bphermansson/EspSparsnasGateway/refrence_doc/RFM69HC_D1mini.png

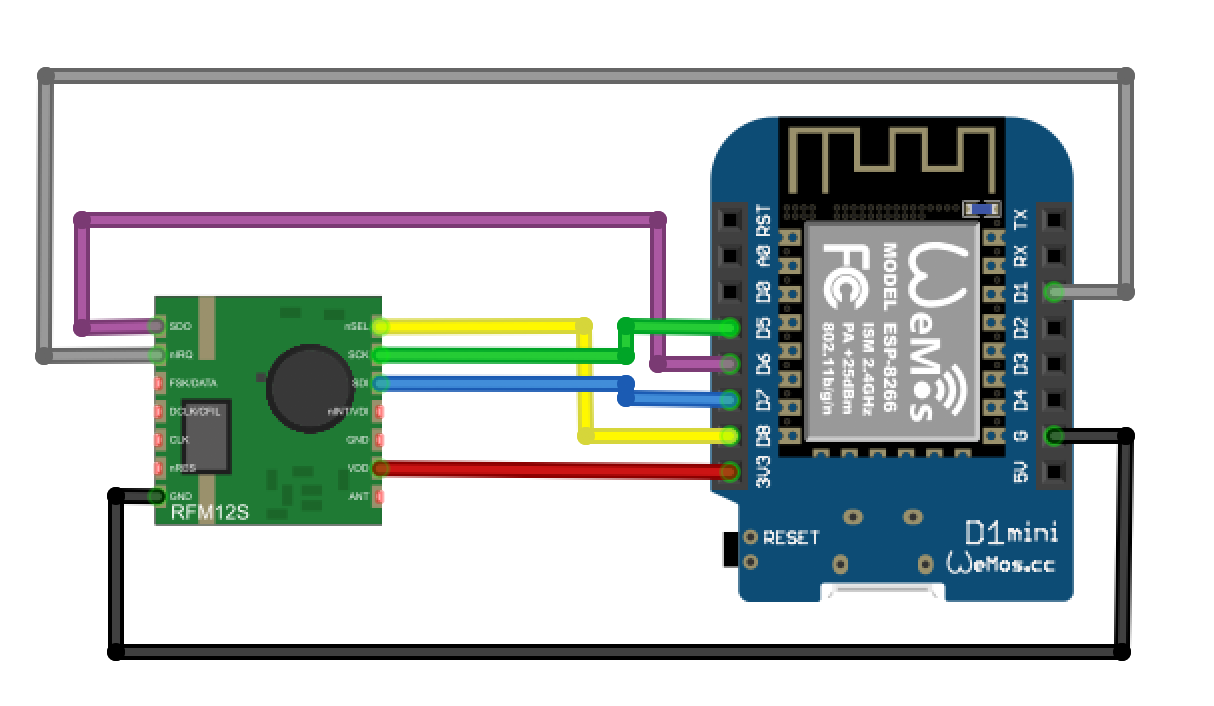
refrence_doc/RFM69HC_D1mini.png
