bphermansson/EspSparsnasGateway/SparnasMqtt.png

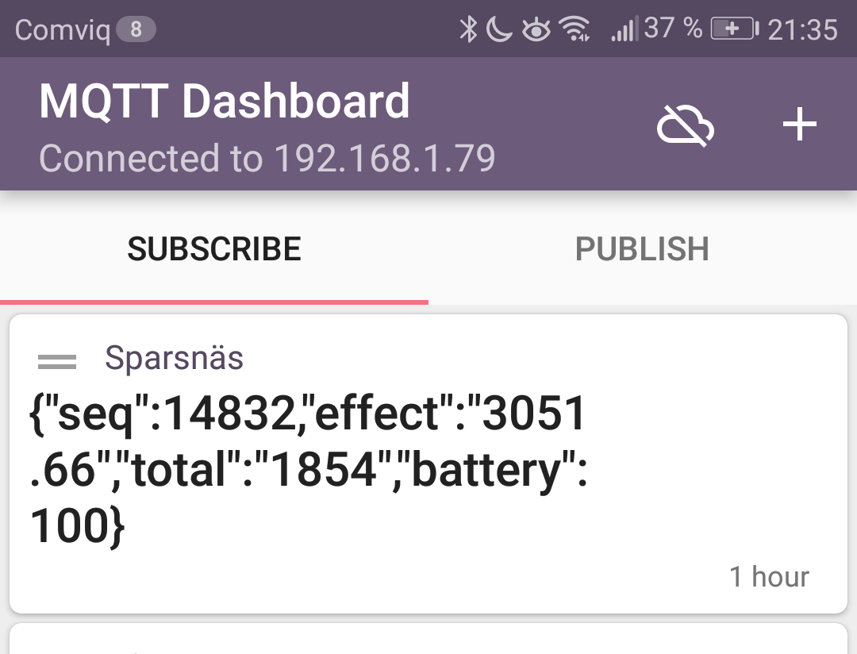
SparnasMqtt.png
