bphermansson/EspSparsnasGateway/(threads)

Thread 1 (2018-01-23):

Port or merge this project to the existing OpenMQTTGateway project?

Hedda, 2018-01-23:
@bphermansson might it be a good idea to port or merge this to the existing OpenMQTTGateway project and maybe join their development team (formerly known as 433toMQTTto433 gateway by 1technophile)?

https://github.com/1technophile/OpenMQTTGateway

OpenMQTTGateway is also a ESP8266 and RFM69 (from HopeRF) RF to MQTT project however it also keeps compatibility with ESP32 and Arduino + W5100 too, and as an additional bonus it supports InfraRed (IR) transmitters and recievers as well:

https://1technophile.github.io/OpenMQTTGateway/

Blog:

https://1technophile.blogspot.se/

RM69 specific blog:

https://1technophile.blogspot.se/2017/09/why-adding-rfm69-compatibility-to.html

Wiki:

https://github.com/1technophile/OpenMQTTGateway/wiki

End-point device compatibility:

https://community.home-assistant.io/t/433tomqttto433-gateway-device-list/7819/7
https://docs.google.com/spreadsheets/d/1DdtVtSsN25nwP6BZI5q6C9yDGz37tUWjw2SQ1RGwBxU/

Good or bad idea?

Hedda, 2018-01-24:
@bphermansson Florian (a.k.a. @1technophile ) wrote here that should be possible if you are willing:

https://gitter.im/OpenMQTTGateway/Questions_support

OpenMQTTGateway project needs a developer who owns a Sparnas and has own interest to add it.

bphermansson, 2018-01-24:
Interresting! Seems like a nice project in many ways. I'll take a look and see what can be done.

Hedda, 2018-01-25:
@bphermansson  Cool! and FYI; another somewhat similar project using ESP8266 and supporting RFM69 is "MySensors":

https://github.com/mysensors/MySensors
https://www.mysensors.org

Interestingly, MySensors (which is a mature project) also happens to come from Swedish developers!

https://github.com/mysensors/MySensors/issues/1034

Posted another seperate feature request for them to implement Sparnas to as linked above.

dogmatic69, 2019-01-21:
This should be closed, it has been a year and these other projects are not interested.

MySensors closed the ticket
OpenMQTTGateway says if they wanted a meter they would build the led blink reader and skip sparsnas.

It's a dead project before it even starts. Had @Hedda perhaps make PR's to these other projects it might have been different but I doubt anything is going to happen.

Closed 2019-01-22.

Thread 3 (2018-01-28):

Rssi always 0

bphermansson, 2018-01-28:
The function to get the Rssi from the receiver always returns 0, should return something like -67.
If we set forceTrigger = true in uint16_t readRSSI (line 304) the code crashes when valid data arrives.

bphermansson, 2018-02-03:
According to the datasheet the rssi can only be read at preamble, ie at start of transmission. The code tries to read it after receiving is done, it should not work. Let's see if we can get and interrupt at the start of transmission and read rssi there instead.

bphermansson, 2018-02-04:
You can also read Rssi just before you read the received package. This is now implemented and this problem is solved.

Closed 2018-02-04.

Thread 4 (2018-01-30):

Issue that values written to MQTT broker does not show the right values

swapper82, 2018-01-30:
When publishing to a mosquitto broker (at least)
i got the values {"seq":989,"power":true,"total":true,"battery":100}
Interprited as bolean values or somting?

i "fixed" the issue by changing to float from string (starting line 458 in the main .ino file)

      else {
        root["seq"] = seq;
        root["power"] = float(watt);
        root["total"] = float(pulse / PULSES_PER_KWH);
        root["battery"] = battery;
        root["rssi"] = float(srssi);
      }

Thanx for a GREAT project :)

bphermansson, 2018-02-03:
Your'e welcome!
Ok, I guess the values are interpreted different with different softwares. But the power and total values are indeed numbers, so I see no problem sending them as floats. I've changed this in the main branch, thanks for the report.

Closed 2018-02-03.

Thread 5 (2018-02-03):

Function to find correct frequency

bphermansson, 2018-02-03:
The transmitter is assumed to send at exactly 868MHz, but that seems to differ between devices. By trial and errror you can get better reception, by changing FREQUENCY in line 69:

uint32_t FREQUENCY = 867980000

It would be nice if the code could find the best frequency by itself.

bphermansson, 2018-02-15:
The new plan is to make it possible to send frequency to use by Mqtt to the unit. This way it will also be possible to set the sender id and maybe more.

Closed 2018-02-18.

Thread 6 (2018-02-11):

Compilation problem

pettib, 2018-02-11:
Hi
I´m trying to compile to project and got error that functions can not be found.
I´m guessing there are something missing, but cant find it.
The board is Wemos D1 running at 115200.

[error.txt](https://github.com/bphermansson/EspSparsnasGateway/files/1714513/error.txt)

regards Peter

bphermansson, 2018-02-15:
Is this the problem with paths that were solved in the Facebook-thread?

Closed 2018-05-03.

Thread 7 (2018-02-12):

Use a Mqtt ping to avoid disconnection

bphermansson, 2018-02-12:
Make the device send a Mqtt message, a "ping", at regular intervalls to avoid disconnection from the broker.

dogmatic69, 2019-01-21:
The pubsub lib already implements a keepalive (`MQTT_KEEPALIVE`) that is pre-set to 15 seconds. There is no need to add another.

dogmatic69, 2019-01-22:
I have configured the ping timeout to a larger value and in 20 minutes have not had a single re-connection.

Closed 2019-01-22.

Thread 8 (2018-02-12):

Setting the frequency via Mqtt

bphermansson, 2018-02-12:
Let the code listen for incoming Mqtt messages with a setting for the receiver frequency. To set the frequency, send something like this:
mosquitto_pub -h 192.168.1.79 -t 'EspSparsnasGateway/settings' -m '{freq:867.999939}'

fredrike, 2018-02-12:
Is it possible to set the sensor ID too?

bphermansson, 2018-02-12:
That would be nice, will give it a try.

bphermansson, 2018-02-18:
The device can now be controlled via Mqtt. We can set the frequency and the senderid, the settings are stored in the Eeprom. We also can clear the settings and reset the device.
But I think theres a bug when setting the frequency, it gets it wrong somehow?

Linuxsmurfen, 2018-04-07:
Could it be that it sets the "ifreq = 868100000;"  on row 317 ?
I tried to remark it and now i'm able to set the frequency via mqtt.

bphermansson, 2018-04-14:
I think that row was for testing. Can you set the frequency and get it right? I haven't managed to get the value set, ie if I set it to 868100000 its reports something like 868000256 back as "Listening on ...".

Naesstrom, 2018-12-10:
I commented out the line on 317 to that @Linuxsmurfen mentioned above, using `EspSparsnasGateway/settings/frequency -m 867.99` give me
```
Message arrived: EspSparsnasGateway/settings/frequency
Payload: 867.99
Frequency change
Set frequency to: 867.99
Wrote: 8
Wrote: 6
Wrote: 7
Wrote: .
Wrote: 9
Wrote: 9
```
Then it reboots and ends the logging with:
```
Stored data:
Found a stored frequency
Stored frequency: 867.99
Calculated frequency: 867990000
There are no stored senderid, using default value
Senderid: 570631
Frequency: 867990000
61.04
Over The Air programming enabled, port: EspSparsnasGateway
Ready
IP address: 192.168.1.201
EspSparsnasGateway @ IP:192.168.1.201 SSID: Katrinelund
In initialize, frequency = 867990000
Adjusted freq: 14221148
61.04
RFM69 init done
Radio initialized.
Listening on 1023999936hz. Done in setup.
```
So even if it says it's saved the new data and repeats it as stored it ends with listenin on another frequency?

bphermansson, 2018-12-19:
Yes. Haven't managed to figure out why.

whyz, 2019-01-09:
fwiw, I have the exact same issue - the requested frequency isn't set. Happy to help in any way I can.

kalj, 2019-01-16:
I guess we can have another go at this now that we have figured out the problem with #20 & #22 ?

dogmatic69, 2019-01-20:
Setting frequency seems to now work, as long as you remove the other line as mentioned above.

Listening on 102399999936hz seems to be a problem with wiring, maybe time to close this ticket?

Closed 2019-01-22.

Thread 9 (2018-02-12):

Calculates wrongly when low/none power usage

tubalainen, 2018-02-12:
The code calculates watts extremely oddly when there isnt a significant load, for example, a load greater than 1000 W.

It reports like 39302 watts when there should be 7 W only.

bphermansson, 2018-02-15:
This we have to look into. Too bad I only have one sender and it's mounted at the power meter. Will see if it's possible to fake values in the code to trigger this bug.

Sperra, 2018-02-18:
Even I have problems with incorrect and extreme values   of effects up to 1.6MW on a 20A main circuit.

The power is calculated according to "watt = (float) ((3600000 / PULSES_PER_KWH) * 1024) / (power);"
Here in the code "power" takes 2bytes.

A high value of "power" will give a low power in W, a value of 65535 produces a minimum power of about 56W. Lower effects seem to get the value of "power" to switch over and start from 0. This seems to match my OpenHab which shows 1.572MW power output. 1.572MW should then correspond to just under 56W the wattage is more reasonable when the values   around such a peak are around 80W.

bphermansson, 2018-02-19:
I'm thinking of letting the code just send raw values, calculations then has to be done by the receiver.

Wonder if this error also shows with Strigeus code, https://github.com/strigeus/sparsnas_decoder?

tubalainen, 2018-02-25:
Looks like the bug exists in the original code as well. Or, there is something fishy with my sparsnäs used for that measurement (got two here at home). The display shows correct values, but both SDR and ESP solution shows the same..

One "ugly fix" is to consider everything under 100 W as 0 in the code... That would help me.

bphermansson, 2018-02-25:
Hmm wait... power is stored in the code as an int, and can therefor be a signed number from -32768 to 32767. The value in the data from the sender is 16 bits with a max of 65535. Not good.
Changing the power type to uint should fix this issue.

bphermansson, 2018-02-25:
That fix is in the code now, hope it works.

fredrike, 2018-02-26:
According to @tubalainen did the `u_int` not help. I've been talking to @bhaap today and apparently was this issue introduced on @tubalainen's code when I changed `PULSES_PER_KWH` from a defined constant to an `int`.

```c
        float watt =  (float)((3600000 / PULSES_PER_KWH) * 1024) / (power);
```

Do we have any samples of output with what the `power` is after the change to `u_int`?  Would it be better to have `power` as `u_int16_t`?

Closed 2018-03-03.

Thread 10 (2018-02-13):

Inductor missing in schematic

bphermansson, 2018-02-13:
Add a inductor (100uH) between the Esp and the Rfm in the schematic.

bphermansson, 2018-02-15:
Fixed

Thread 16 (2018-03-29):

Cannot upload sketch to NodeMCU

pornstrup, 2018-03-29:
Im trying to upload your code to the NodeMCU v.3, but always get an error in arduino saying:
call of overloaded 'readRSSI()' is ambiguous

and this line is marked red:
` uint16_t srssi = readRSSI();`
I´ve downloaded the libraries needed but still get the error. Hope you can help, thanks.

Copy of error message:

Arduino: 1.8.5 (Windows 10), Board: "NodeMCU 1.0 (ESP-12E Module), 80 MHz, 4M (1M SPIFFS), v2 Lower Memory, Disabled, None, Only Sketch, 115200"

C:\Users\Peter Juul Ornstrup\Documents\EspSparsnasGateway-master\EspSparsnasGateway\EspSparsnasGateway.ino: In function 'void interruptHandler()':

EspSparsnasGateway:424: error: call of overloaded 'readRSSI()' is ambiguous

       uint16_t srssi = readRSSI();

                                 ^

C:\Users\Peter Juul Ornstrup\Documents\EspSparsnasGateway-master\EspSparsnasGateway\EspSparsnasGateway.ino:424:33: note: candidates are:

C:\Users\Peter Juul Ornstrup\Documents\EspSparsnasGateway-master\EspSparsnasGateway\RFM69functions.ino:45:10: note: uint16_t readRSSI()

 uint16_t readRSSI() {

          ^

C:\Users\Peter Juul Ornstrup\Documents\EspSparsnasGateway-master\EspSparsnasGateway\EspSparsnasGateway.ino:303:10: note: uint16_t readRSSI(bool)

 uint16_t readRSSI(bool forceTrigger = false) {  // Settings this to true gives a crash...

          ^

C:\Users\Peter Juul Ornstrup\Documents\EspSparsnasGateway-master\EspSparsnasGateway\RFM69functions.ino: In function 'uint32_t getFrequency()':

RFM69functions:1: error: redefinition of 'uint32_t getFrequency()'

 uint32_t getFrequency() {

          ^

EspSparsnasGateway:268: error: 'uint32_t getFrequency()' previously defined here

 uint32_t getFrequency() {

          ^

C:\Users\Peter Juul Ornstrup\Documents\EspSparsnasGateway-master\EspSparsnasGateway\RFM69functions.ino: In function 'void receiveBegin()':

RFM69functions:4: error: redefinition of 'void receiveBegin()'

 void receiveBegin() {

      ^

EspSparsnasGateway:272: error: 'void receiveBegin()' previously defined here

 void receiveBegin() {

      ^

C:\Users\Peter Juul Ornstrup\Documents\EspSparsnasGateway-master\EspSparsnasGateway\RFM69functions.ino: In function 'uint8_t readReg(uint8_t)':

RFM69functions:16: error: redefinition of 'uint8_t readReg(uint8_t)'

 uint8_t readReg(uint8_t addr) {

         ^

EspSparsnasGateway:320: error: 'uint8_t readReg(uint8_t)' previously defined here

 uint8_t readReg(uint8_t addr) {

         ^

C:\Users\Peter Juul Ornstrup\Documents\EspSparsnasGateway-master\EspSparsnasGateway\RFM69functions.ino: In function 'void writeReg(uint8_t, uint8_t)':

RFM69functions:24: error: redefinition of 'void writeReg(uint8_t, uint8_t)'

 void writeReg(uint8_t addr, uint8_t value) {

      ^

EspSparsnasGateway:328: error: 'void writeReg(uint8_t, uint8_t)' previously defined here

 void writeReg(uint8_t addr, uint8_t value) {

      ^

C:\Users\Peter Juul Ornstrup\Documents\EspSparsnasGateway-master\EspSparsnasGateway\RFM69functions.ino: In function 'void select()':

RFM69functions:32: error: redefinition of 'void select()'

 void select() {

      ^

EspSparsnasGateway:336: error: 'void select()' previously defined here

 void select() {

      ^

C:\Users\Peter Juul Ornstrup\Documents\EspSparsnasGateway-master\EspSparsnasGateway\RFM69functions.ino: In function 'void unselect()':

RFM69functions:38: error: redefinition of 'void unselect()'

 void unselect() {

      ^

EspSparsnasGateway:342: error: 'void unselect()' previously defined here

 void unselect() {

      ^

C:\Users\Peter Juul Ornstrup\Documents\EspSparsnasGateway-master\EspSparsnasGateway\RFM69functions.ino: In function 'uint16_t readRSSI()':

RFM69functions:56: error: 'rssi' was not declared in this scope

   rssi = -readReg(REG_RSSIVALUE);

   ^

C:\Users\Peter Juul Ornstrup\Documents\EspSparsnasGateway-master\EspSparsnasGateway\RFM69functions.ino: In function 'bool receiveDone()':

RFM69functions:64: error: redefinition of 'bool receiveDone()'

 bool receiveDone() {

      ^

EspSparsnasGateway:284: error: 'bool receiveDone()' previously defined here

 bool receiveDone() {

      ^

C:\Users\Peter Juul Ornstrup\Documents\EspSparsnasGateway-master\EspSparsnasGateway\RFM69functions.ino: In function 'uint16_t crc16(volatile uint8_t*, size_t)':

RFM69functions:82: error: redefinition of 'uint16_t crc16(volatile uint8_t*, size_t)'

 uint16_t crc16(volatile uint8_t *data, size_t n) {

          ^

EspSparsnasGateway:522: error: 'uint16_t crc16(volatile uint8_t*, size_t)' previously defined here

 uint16_t crc16(volatile uint8_t *data, size_t n) {

          ^

C:\Users\Peter Juul Ornstrup\Documents\EspSparsnasGateway-master\EspSparsnasGateway\callback.ino: In function 'void callback(char*, byte*, unsigned int)':

callback:2: error: redefinition of 'void callback(char*, byte*, unsigned int)'

 void callback(char* topic, byte* payload, unsigned int length) {

      ^

EspSparsnasGateway:566: error: 'void callback(char*, byte*, unsigned int)' previously defined here

 void callback(char* topic, byte* payload, unsigned int length) {

      ^

callback:38: error: 'EEPROM' was not declared in this scope

         EEPROM.write(addr, 1); // Indicate stored settings by writing 1 to Eeprom address 0

         ^

callback:52: error: 'mqtt_debug_topic' was not declared in this scope

         client.publish(mqtt_debug_topic, msg);

                        ^

callback:66: error: 'EEPROM' was not declared in this scope

       EEPROM.write(addr, 1);    // Indicate stored settings by writing 1 to Eeprom address 1

       ^

callback:82: error: 'mqtt_debug_topic' was not declared in this scope

       client.publish(mqtt_debug_topic, msg);

                      ^

callback:90: error: 'EEPROM' was not declared in this scope

         EEPROM.write(i, 0);

         ^

callback:92: error: 'EEPROM' was not declared in this scope

       EEPROM.commit();

       ^

callback:96: error: 'mqtt_debug_topic' was not declared in this scope

       client.publish(mqtt_debug_topic, msg);

                      ^

callback:105: error: 'mqtt_debug_topic' was not declared in this scope

       client.publish(mqtt_debug_topic, msg);

                      ^

exit status 1
call of overloaded 'readRSSI()' is ambiguous

This report would have more information with
"Show verbose output during compilation"
option enabled in File -> Preferences.

bphermansson, 2018-03-31:
You dont need no libraries. Do you have the code in tabs?

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

pornstrup, 2018-03-31:
Yes got the codes in tabs. Will try and start from scratch and see if that helps. Will get back to you. Thanks.

Closed 2018-05-03.

Thread 17 (2018-04-18):

SPI write problem

leifmariposa, 2018-04-18:
Hi,

I have built my own EspSparsnäsGateway with the same parts as in your parts list, but cannot get SPI to write any values. Reading is fine, I always read the default values of the RFM69, no matter what values I have written. For example, first thing that happens in your program is writing 0xAA to REG_SYNCVALUE1, but it always reads as 0x00.
I have connected a logic analyzer on the SPI signals, and it looks fine, MSB is set in the address byte when doing a write.

Also, shouldn't the connection D8(NodeMCU) - EN(RFM69) be D8(NodeMCU) - CS(RFM69) ?

Any help appreciated!

BR
Leif Persson

leifmariposa, 2018-05-06:
I tried to simplify the software as much as possible, but of course the didn't help, the output on SPI is the same according to the logicanalyzer and that seems correct to me after reading the data sheet of the RFM69HCW many times. Today I have ordered new nodemcu and rfm69hcw, will be interesting to see if that will work...

leifmariposa, 2018-05-08:
OK, got a new nodemcu and a new rfm69hcw but with the same result.
This is what the logic analyzer sees: https://ibb.co/bSVzKS

bphermansson, could you please check your connection?
Because I changed the connection between nodemcu-D8 from EN on rfm69 to CS on rfm69, at least reads are working with this. Should the EN on rfm69 be connected?

When studying the logic analyzer output closer you can see that MISO (slave output) goes high immediately after the address byte is sent, regardless if the write bit in the address byte is set or not. Not sure what to make of this though.

Still so confused...

bphermansson, 2018-05-08:
Sorry to hear that. It must be some confusion with the connections. I will take a closer look.
Exactly which components did you buy?

leifmariposa, 2018-05-08:
I bought in at Lawicel,

RFM69HCW Transceiver BoB
Artikelnr: ADA-3070

NodeMCU V3 with ESP-12E / CH340
Artikelnr: K-NM-ESP12E

It should be the components that you recommended but your links doesn't work anymore. I think they changed the url's at Lawicel.

bphermansson, 2018-05-09:
Now I've built another circuit on a protoboard with another RFM69 and another Nodemcu. I used my schematic, unmodified, and the pinout for the Rfm from https://www.mysensors.org/build/connect_radio.
Works just like it should. Hmm.

leifmariposa, 2018-05-09:
Thanks for taking the time to investigate!
When checking mysensors.org I can't fint any break out boards, does this mean you connected directly to a RFM69(HCW) ? Because I can't find any EN signal on the RFM69, only on the break out board, and I left it unconnected on my circuit. Could this maybe be the problem?

bphermansson, 2018-05-09:
Indeed it can. I used a plain Rfm without any breakout board. As noted in my schematic NSS=En.

leifmariposa, 2018-05-11:
OK, so I connected the EN signal on the RFM69 as well, to another output on the nodemcu and then I have tried all possible combinations using the CS and EN signals. NSS=CS, not EN, EN controls the power on/off on the break out board.
So the EN signal must be held high, andwhen it's unconnected it's held high through a pull-up resistor on the break out board.
But I can still not get it to work, from what I can tell the logic analyzer shows that the SPI output is correct, but the RFM69 refuses to make any writes...
The only thing I can think of is that the compunents that I bought is not compatible, could the power supply be too weak?
@bphermansson, exactly which components did you use? And where did you by them?
Or would you be willing to sell me a pair of working NodeMcu/RFM69 if you have extra?

bphermansson, 2018-05-15:
This is your breakout? https://www.adafruit.com/product/3070
It has a level converter and a voltage regulator. Do you connect 5V to Vin?
I have a RFM to sell if you want, but not many Nodemcu:s.

leifmariposa, 2018-05-16:
Yes, that is the breakout I'm using, I have tried with both 3.3V and 5V supply, same problem.
I've recently found this, Adafruit Feather M0 RFM69HCW Packet Radio
https://www.lawicel-shop.se/catalog/product/view/id/5656/s/adafruit-feather-m0-rfm69hcw-packet-radio/
so I will by that one instead to get rid of all this hassle, it's not very expensive.
Anyway, thanks for all your help!

bphermansson, 2018-05-24:
Ok, hope that works!

mircopz, 2021-05-28:
@leifmariposa did you solve the write error problem with RFM69? I'm facing the same issue...

mircopz, 2021-05-31:
@leifmariposa I don't know if you are still interested in... I saw that you participated in this topic https://forums.adafruit.com/viewtopic.php?f=19&p=672114
I had the same registers dump when reading, and I solved it when I changed reset pin logic. It's not active low (as the 99% of devices), but active high! So I was communicating with it in reset conditions, and maybe only some registers latch the default values.
Inverting the reset logic everything works correctly.

leifmariposa, 2021-05-31:
Great that you got it working! I'm using another solution now, but thanks for the info!

Closed 2019-01-22.

Thread 20 (2018-08-05):

Listening to the wrong frequency

Freland, 2018-08-05:
For some reason the log gives me "Listening on 1023999936hz. Done in setup." even though I've set the frequency: "Stored frequency: 867999900". Since it is listening to the wrong freq. I don't get any data. I've tried updating the freq. with MQTT with no luck.

Logfile:
```
Debug on
Vcc=3014
Stored data: 1
There are stored settings
Stored frequency: 867999900
Stored sender id: d2a94a
Over The Air programming enabled, port: EspSparsnasGateway
Attempting MQTT connection...Connected to Mqtt broker as EspSparsnasGateway
Ready
IP address: 192.168.1.XX
EspSparsnasGateway @ IP:192.168.1.XX SSID: XXXXXX
Stored freq: 867999900
RFM69 init done
Radio initialized.
Listening on 1023999936hz. Done in setup.
```

kalj, 2019-01-13:
See #22 and #25 . Can probably be closed.

dogmatic69, 2019-01-18:
I have been debugging this tonight and think I have found the problem. The frequency is not written to the registry on the board (or possibly the read is not working)

```
  Serial.print("frequency: ");
  Serial.println(frequency);
  for (uint8_t i = 0; CONFIG[i][0] != 255; i++) {
    Serial.print("writeReg: ");
    Serial.print(CONFIG[i][0]);
    Serial.print(": ");
    Serial.println(CONFIG[i][1]);
    writeReg(CONFIG[i][0], CONFIG[i][1]);
    yield();
  }
```
gives the following output (trimmed for brevity):

```
22:35:08.830 -> frequency: 1422114
....
22:35:08.830 -> writeReg: 7: 21
22:35:08.830 -> writeReg: 8: 179
22:35:08.830 -> writeReg: 9: 34
```

Whilst the `getFrequency` method call has this:

```
  Serial.println("readReg: ");

  Serial.print(REG_FRFMSB);
  Serial.print(": ");
  Serial.println((readReg(REG_FRFMSB)));

  Serial.print(REG_FRFMID);
  Serial.print(": ");
  Serial.println(readReg(REG_FRFMID));

  Serial.print(REG_FRFLSB);
  Serial.print(": ");
  Serial.println(readReg(REG_FRFLSB));

  Serial.print("frequency: ");
  Serial.println((
    ((uint32_t)readReg(REG_FRFMSB) << 16) +
    ((uint16_t)readReg(REG_FRFMID) << 8) +
    (uint8_t)readReg(REG_FRFLSB)
  ));
```

And the output is:
```
22:35:08.863 -> readReg:
22:35:08.863 -> 7: 255
22:35:08.863 -> 8: 255
22:35:08.863 -> 9: 255
22:35:08.863 -> frequency: 16777215
```

kalj, 2019-01-19:
@dogmatic69 Are your issue the same as the one we eventually sorted out in #22 ? Many of us had this exact problem when the MOSI/MISO wires were swapped and/or leaving the RST pin of the Adafruit RFM69HCW BoB unwired to ground. Using the new schematic #27 it seems we all get it to work. Also, have you included the error checks in #25? Those can help ruling out a failed initialization.

dogmatic69, 2019-01-19:
Was missing the reset connected to ground! Now the registries are written.

bphermansson, 2019-01-19:
Great work! Since I lack time for this project I invited Naesstrom and Freland as collaborators. Anyone else wanna join?

kalj, 2019-01-19:
@bphermansson I would love to tag along. :)

dogmatic69, 2019-01-23:
This should now be sorted. If still getting that it listens to the wrong frequency check the wiring and make sure that registries that are written to actually have the correct values (eg: write -> read -> compare value). If that does not work the frequency is not being written to the registry and is probably due to wiring issue.

Closed 2019-01-23.

Thread 21 (2018-09-12):

Text corrections?

Naesstrom, 2018-09-12:
Just wanted to check what instructions to follow, in the build instructions you suggest using a "330-470uF" capacitor but in the links and the schematic it's a 1000uF?

Naesstrom, 2018-09-20:
Sweet, still waiting for my PCB's but think I have all the parts already!
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

Closed 2018-10-31.

Thread 22 (2018-10-31):

No values?

Naesstrom, 2018-10-31:
So I finally got around to assembling this, even added a sma contact and a 868 antenna to the breakout board.
Serial monitor just gives me this:
```
Attempting MQTT connection...Connected to Mqtt broker as EspSparsnasGateway
Stored data:
There are no stored frequency, using default value
There are no stored senderid, using default value
Senderid: 570631
Frequency: 868000000
61.04
Over The Air programming enabled, port: EspSparsnasGateway
Ready
IP addre
```
The senderid is the one I entered and the frequency looks right to, the strange thing is that it cuts out before it even tells me the IP... Debug is set to 1 btw.

On the mqtt side of things it repeats the following 4 rows a couple of times
```
{"status":"Connected to Mqtt broker as EspSparsnasGateway"}
{"status":"There are no stored frequency, using default value"}
{"status":"There are no stored senderid, using default value"}
{"status":"EspSparsnasGateway @ IP:192.168.1.201 SSID: Katrinelund"}
```

The really strange thing tough is that if I disconnect the ESP from everything and run it the monitor seems to work?
```
Attempting MQTT connection...Connected to Mqtt broker as EspSparsnasGateway
Stored data:
There are no stored frequency, using default value
There are no stored senderid, using default value
Senderid: 570631
Frequency: 868000000
61.04
Over The Air programming enabled, port: EspSparsnasGateway
Ready
IP address: 192.168.1.201
EspSparsnasGateway @ IP:192.168.1.201 SSID: Katrinelund
In initialize, frequency = 868100000
Adjusted freq: 14222950
61.04
RFM69 init done
Radio initialized.
Listening on 1023999936hz. Done in setup.
```

Naesstrom, 2018-10-31:
Did some more debugging, running the ESP with everything but the RFM69 unit I get a complete startup in the serial monitor to... starting to think that my module might be DOA...

bphermansson, 2018-10-31:
What esp-module are you using? What kind of power supply?

Naesstrom, 2018-11-01:
NodeMCU v3 (lolin) and just USB power from the PC atm.

Naesstrom, 2018-11-03:
Running it with a 1A external poweradapter gives me:
```
Welcome to EspSparsnasGateway
Compiled at:Oct 30 2018 21:51:42
Debug on
Vcc=2923
Attempting MQTT connection...Connected to Mqtt broker as EspSparsnasGateway
Stored data:
There are no stored frequency, using default value
There are no stored senderid, using default value
Senderid: 570631
Frequency: 868000000
61.04
Over The Air programming enabled, port: EspSparsnasGateway
Ready
IP address: 192.168.1.201
EspSparsnasGateway @ IP:192.168.1.201 SSID: Katrinelund
In initialize, frequency = 868100000
Adjusted freq: 14222950
61.04
Failed on waiting for ModeReady()
Unable to initialize the radio. Exiting.
```
Not sure what it means with `Failed on waiting for ModeReady()`

bphermansson, 2018-11-03:
Can you try to set the frequency in the code?

Naesstrom, 2018-11-07:
Redid the wiring on a breadboard but still the same result when connecting 12V power... Radio is getting 3.3V to.
```
Compiled at:Oct 30 2018 21:51:42
Debug on
Vcc=2928
Attempting MQTT connection...Connected to Mqtt broker as EspSparsnasGateway
Stored data:
There are no stored frequency, using default value
There are no stored senderid, using default value
Senderid: 570631
Frequency: 868000000
61.04
Over The Air programming enabled, port: EspSparsnasGateway
Ready
IP address: 192.168.1.201
EspSparsnasGateway @ IP:192.168.1.201 SSID: Katrinelund
In initialize, frequency = 868100000
Adjusted freq: 14222950
61.04
Failed on waiting for ModeReady()
Unable to initialize the radio. Exiting.
```

Naesstrom, 2018-11-07:
Been googling and trying to find what might be causing it... only thing I found is related to the [rst pin](https://forum.mysensors.org/topic/5954/rfm69-not-initialising-required-reset-could-be-the-cause/5) but since it's been working for you it can't be that!

bphermansson, 2018-11-08:
Maybe try another software to see if it's a hardware or software problem? Like this: https://github.com/bbx10/nanohab

Naesstrom, 2018-11-08:
yup, that seems to be initializing the radio
```
RFM69 WiFi Gateway
External System
*WM:
*WM: AutoConnect
*WM: Connecting as wifi client...
*WM: Using last saved values, should be faster
*WM: Connection result:
*WM: 3
*WM: IP Address:
*WM: 192.168.1.201
connected
*WM: freeing allocated params!
MDNS responder started
Connect to http://rfm69gw1.local or http://192.168.1.201

Listening at 868 86 MHz
Attempting MQTT connection...failed, rc=-2 try again in 2 seconds
```
Having some problems with my mqtt atm. tough but thats unrelated.

Just a thought, I'm using a RFM69HCW and in the software you linked he differs between them for some reason with `    radio.setHighPower();    // Only for RFM69HCW & HW!` can that be something?

Sorry for being such a PITA btw

bphermansson, 2018-11-15:
Might be, try to comment that line?

Naesstrom, 2018-11-19:
Not sure I follow what you mean right now, this software that you linked https://github.com/bbx10/nanohab managed to initialize the radio- The part with `radio.setHighPower` is from that git and not yours.
Do you mean I should comment that out from the above mentioned firmware and see if it still initializes the radio?

Naesstrom, 2018-12-10:
After switching mosi/miso I got it booting up atleast... D6 --> MOSI and D7 --> MISO
Can't really understand why since according to all the sheets I can read it shouldn't work this way...
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

```
Compiled at:Nov  8 2018 16:43:01
Debug on
Vcc=2928
Attempting MQTT connection...Connected to Mqtt broker as EspSparsnasGateway
Stored data:
There are no stored frequency, using default value
There are no stored senderid, using default value
Senderid: 570631
Frequency: 868000000
61.04
Over The Air programming enabled, port: EspSparsnasGateway
Ready
IP address: 192.168.1.201
EspSparsnasGateway @ IP:192.168.1.201 SSID: Katrinelund
In initialize, frequency = 868100000
Adjusted freq: 14222950
61.04
RFM69 init done
Radio initialized.
Listening on 1023999936hz. Done in setup.
```

Freland, 2018-12-10:
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

Seems like it is exactly the same issue I had when I tried getting it up and running a while back ago (https://github.com/bphermansson/EspSparsnasGateway/issues/20 )

Naesstrom, 2018-12-10:
hehe, ja det var ditt förslag i [elektronikforumet](http://elektronikforumet.com/forum/viewtopic.php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) som gav mig iden att testa att switcha plats på dom!
Har du någonsin fått det att fungera @Freland

Naesstrom, 2018-12-11:
Efter att ha diskuterat på FB, granskat kopplingsscheman etc. har jag en ny fundering... Enligt sommarlov's skiss så skall ju NSS kopplas till GPIO15 och det skriver @bphermansson i sin schematic!

Kollar jag däremot på Adafruits egna inkopplingsschema för RFM69HCW så har dom ingen koppling till EN då den automatiskt är på men däremot från samma GPIO till CS
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

Naesstrom, 2018-12-11:
Typ såhär:
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

dogmatic69, 2019-01-16:
> RST - this is the Reset pin for the radio. It's pulled high by default. Pull down to ground to put it into reset

Seems that you should pull it down to reset, not permanently.

Naesstrom, 2019-01-17:
Hmm, then it should be done in the code then... I'm running mine now with gnd connected to it and it seems to be running fine

dogmatic69, 2019-01-23:
I'm going to go ahead and close this issue as the code fixes are now in and the other part seems to be a hookup issue. If you still got an error open a new ticket for it.

Closed 2019-01-23.

Thread 28 (2019-01-19):

Bad data

dogmatic69, 2019-01-19:
Now I have it running, but the data seems to be bad. I've tried to change the flag in the config mentioned in the readme but that did not help.

```
    if (TEMPDATA[0] != 0x11 || TEMPDATA[1] != (SENSOR_ID & 0xFF) || TEMPDATA[3] != 0x07 || rcv_sensor_id != SENSOR_ID) {
      Serial.println("Bad data");

      Serial.print("data_0: ");
      Serial.println(TEMPDATA[0]);

      Serial.print("data_1: ");
      Serial.println(TEMPDATA[1]);

      Serial.print("SENSOR_ID & 0xFF: ");
      Serial.println(SENSOR_ID & 0xFF);

      Serial.print("data_3: ");
      Serial.println(TEMPDATA[3]);

      Serial.print("rcv_sensor_id: ");
      Serial.println(rcv_sensor_id);

      Serial.print("SENSOR_ID: ");
      Serial.println(SENSOR_ID);
```

output:

```
08:51:27.321 -> Got rf data
08:51:27.321 -> Bad data
08:51:27.321 -> data_0: 238
08:51:27.321 -> data_1: 101
08:51:27.321 -> SENSOR_ID & 0xFF: 93
08:51:27.355 -> data_3: 196
08:51:27.355 -> rcv_sensor_id: 215117836
08:51:27.355 -> SENSOR_ID: 542045
08:51:33.333 -> Got rf data
08:51:33.333 -> Bad data
08:51:33.333 -> data_0: 85
08:51:33.333 -> data_1: 93
08:51:33.333 -> SENSOR_ID & 0xFF: 93
08:51:33.333 -> data_3: 69
08:51:33.333 -> rcv_sensor_id: 4157798087
08:51:33.333 -> SENSOR_ID: 542045
```

dogmatic69, 2019-01-19:
Got it working now by commenting out the hard coded value for the sensor before `initialize`. Not sure why that is even there when you are setting it above or via MQTT.

Seen some other posts here about removing it so maybe it should be removed totally...
```
  // ifreq = 868100000;
```

Naesstrom, 2019-01-21:
Thanks, I'll make sure to edit that out of the code!

Closed 2019-01-21.

Thread 30 (2019-01-20):

MQTT is not stable, many missed packets.

dogmatic69, 2019-01-20:
After running for a while this is my logs, you can see many missed pakets. The Sparsnas is sending around every 15 seconds (seen in the serial debugger), but the MQTT subscriber is only getting a fraction of what is sent.

Look at the `seq` below, this is what MQTT is actually processing.

```$ mosquitto_sub -v -h hassio.home -V mqttv311 -u mqtt -P mqtt -t "EspSparsnasGateway/#"
EspSparsnasGateway/debug {"status":"Connected to Mqtt broker as EspSparsnasGateway"}
EspSparsnasGateway/values {"seq":43362,"watt":2792.727,"total":205.451,"pulse":"205451","battery":100,"rssi":"-101","power":"1320"}
EspSparsnasGateway/debug {"status":"Connected to Mqtt broker as EspSparsnasGateway"}
EspSparsnasGateway/values {"seq":43384,"watt":2378.323,"total":205.702,"pulse":"205702","battery":100,"rssi":"-86","power":"1550"}
EspSparsnasGateway/debug {"status":"Connected to Mqtt broker as EspSparsnasGateway"}
EspSparsnasGateway/debug {"status":"Connected to Mqtt broker as EspSparsnasGateway"}
EspSparsnasGateway/debug {"status":"Connected to Mqtt broker as EspSparsnasGateway"}
EspSparsnasGateway/debug {"status":"Connected to Mqtt broker as EspSparsnasGateway"}
EspSparsnasGateway/debug {"status":"Connected to Mqtt broker as EspSparsnasGateway"}
EspSparsnasGateway/values {"seq":43558,"watt":2963.344,"total":207.677,"pulse":"207677","battery":100,"rssi":"-85","power":"1244"}
EspSparsnasGateway/values {"seq":43564,"watt":3056.716,"total":207.753,"pulse":"207753","battery":100,"rssi":"-93","power":"1206"}
EspSparsnasGateway/debug {"status":"Connected to Mqtt broker as EspSparsnasGateway"}
EspSparsnasGateway/debug {"status":"Connected to Mqtt broker as EspSparsnasGateway"}
EspSparsnasGateway/values {"seq":43608,"watt":1253.025,"total":208.207,"pulse":"208207","battery":100,"rssi":"-84","power":"2942"}
EspSparsnasGateway/debug {"status":"Connected to Mqtt broker as EspSparsnasGateway"}
EspSparsnasGateway/debug {"status":"Connected to Mqtt broker as EspSparsnasGateway"}
EspSparsnasGateway/values {"seq":43652,"watt":1466.348,"total":208.467,"pulse":"208467","battery":100,"rssi":"-94","power":"2514"}
EspSparsnasGateway/debug {"status":"Connected to Mqtt broker as EspSparsnasGateway"}
EspSparsnasGateway/debug {"status":"Connected to Mqtt broker as EspSparsnasGateway"}
EspSparsnasGateway/values {"seq":43677,"watt":701.3699,"total":208.602,"pulse":"208602","battery":100,"rssi":"-86","power":"5256"}
EspSparsnasGateway/debug {"status":"Connected to Mqtt broker as EspSparsnasGateway"}
EspSparsnasGateway/values {"seq":43788,"watt":607.7151,"total":208.878,"pulse":"208878","battery":100,"rssi":"-82","power":"6066"}
EspSparsnasGateway/debug {"status":"Connected to Mqtt broker as EspSparsnasGateway"}
EspSparsnasGateway/values {"seq":43793,"watt":920.6793,"total":208.892,"pulse":"208892","battery":100,"rssi":"-91","power":"4004"}
EspSparsnasGateway/debug {"status":"Connected to Mqtt broker as EspSparsnasGateway"}
EspSparsnasGateway/debug {"status":"Connected to Mqtt broker as EspSparsnasGateway"}
EspSparsnasGateway/values {"seq":43840,"watt":1044.602,"total":209.011,"pulse":"209011","battery":100,"rssi":"-90","power":"3529"}
EspSparsnasGateway/debug {"status":"Connected to Mqtt broker as EspSparsnasGateway"}
EspSparsnasGateway/debug {"status":"Connected to Mqtt broker as EspSparsnasGateway"}
EspSparsnasGateway/values {"seq":43882,"watt":7200,"total":209.107,"pulse":"209107","battery":100,"rssi":"-88","power":"512"}
EspSparsnasGateway/debug {"status":"Connected to Mqtt broker as EspSparsnasGateway"}
EspSparsnasGateway/debug {"status":"Connected to Mqtt broker as EspSparsnasGateway"}
EspSparsnasGateway/debug {"status":"Connected to Mqtt broker as EspSparsnasGateway"}
EspSparsnasGateway/values {"seq":43935,"watt":641.3361,"total":209.275,"pulse":"209275","battery":100,"rssi":"-87","power":"5748"}
EspSparsnasGateway/debug {"status":"Connected to Mqtt broker as EspSparsnasGateway"}
EspSparsnasGateway/values {"seq":43939,"watt":560.7545,"total":209.285,"pulse":"209285","battery":100,"rssi":"-86","power":"6574"}
EspSparsnasGateway/debug {"status":"Connected to Mqtt broker as EspSparsnasGateway"}
EspSparsnasGateway/values {"seq":43972,"watt":457.0295,"total":209.371,"pulse":"209371","battery":100,"rssi":"-85","power":"8066"}
EspSparsnasGateway/debug {"status":"Connected to Mqtt broker as EspSparsnasGateway"}
EspSparsnasGateway/debug {"status":"Connected to Mqtt broker as EspSparsnasGateway"}
EspSparsnasGateway/debug {"status":"Connected to Mqtt broker as EspSparsnasGateway"}
EspSparsnasGateway/values {"seq":44011,"watt":1142.715,"total":209.579,"pulse":"209579","battery":100,"rssi":"-88","power":"3226"}
EspSparsnasGateway/debug {"status":"Connected to Mqtt broker as EspSparsnasGateway"}
EspSparsnasGateway/debug {"status":"Connected to Mqtt broker as EspSparsnasGateway"}
EspSparsnasGateway/debug {"status":"Connected to Mqtt broker as EspSparsnasGateway"}
EspSparsnasGateway/values {"seq":44126,"watt":996.3243,"total":210.235,"pulse":"210235","battery":100,"rssi":"-90","power":"3700"}
EspSparsnasGateway/debug {"status":"Connected to Mqtt broker as EspSparsnasGateway"}
EspSparsnasGateway/debug {"status":"Connected to Mqtt broker as EspSparsnasGateway"}
EspSparsnasGateway/debug {"status":"Connected to Mqtt broker as EspSparsnasGateway"}
EspSparsnasGateway/values {"seq":44171,"watt":3145.393,"total":210.74,"pulse":"210740","battery":100,"rssi":"-85","power":"1172"}
EspSparsnasGateway/debug {"status":"Connected to Mqtt broker as EspSparsnasGateway"}
EspSparsnasGateway/debug {"status":"Connected to Mqtt broker as EspSparsnasGateway"}
EspSparsnasGateway/values {"seq":44199,"watt":3432.402,"total":211.139,"pulse":"211139","battery":100,"rssi":"-85","power":"1074"}
EspSparsnasGateway/debug {"status":"Connected to Mqtt broker as EspSparsnasGateway"}
EspSparsnasGateway/debug {"status":"Connected to Mqtt broker as EspSparsnasGateway"}
EspSparsnasGateway/debug {"status":"Connected to Mqtt broker as EspSparsnasGateway"}
EspSparsnasGateway/debug {"status":"Connected to Mqtt broker as EspSparsnasGateway"}
EspSparsnasGateway/debug {"status":"Connected to Mqtt broker as EspSparsnasGateway"}
EspSparsnasGateway/debug {"status":"Connected to Mqtt broker as EspSparsnasGateway"}
EspSparsnasGateway/debug {"status":"Connected to Mqtt broker as EspSparsnasGateway"}
EspSparsnasGateway/debug {"status":"Connected to Mqtt broker as EspSparsnasGateway"}
EspSparsnasGateway/debug {"status":"Connected to Mqtt broker as EspSparsnasGateway"}
EspSparsnasGateway/values {"seq":44371,"watt":6083.168,"total":212.872,"pulse":"212872","battery":100,"rssi":"-82","power":"606"}
EspSparsnasGateway/debug {"status":"Connected to Mqtt broker as EspSparsnasGateway"}
EspSparsnasGateway/values {"seq":44381,"watt":3824.066,"total":213.062,"pulse":"213062","battery":100,"rssi":"-87","power":"964"}
EspSparsnasGateway/values {"seq":44382,"watt":4015.686,"total":213.078,"pulse":"213078","battery":100,"rssi":"-94","power":"918"}
EspSparsnasGateway/debug {"status":"Connected to Mqtt broker as EspSparsnasGateway"}
EspSparsnasGateway/debug {"status":"Connected to Mqtt broker as EspSparsnasGateway"}
EspSparsnasGateway/debug {"status":"Connected to Mqtt broker as EspSparsnasGateway"}
EspSparsnasGateway/values {"seq":44399,"watt":5008.696,"total":213.4,"pulse":"213400","battery":100,"rssi":"-91","power":"736"}
EspSparsnasGateway/debug {"status":"Connected to Mqtt broker as EspSparsnasGateway"}
EspSparsnasGateway/debug {"status":"Connected to Mqtt broker as EspSparsnasGateway"}
EspSparsnasGateway/debug {"status":"Connected to Mqtt broker as EspSparsnasGateway"}
EspSparsnasGateway/values {"seq":44410,"watt":4596.509,"total":213.623,"pulse":"213623","battery":100,"rssi":"-89","power":"802"}
EspSparsnasGateway/values {"seq":44411,"watt":4585.075,"total":213.642,"pulse":"213642","battery":100,"rssi":"-82","power":"804"}
EspSparsnasGateway/debug {"status":"Connected to Mqtt broker as EspSparsnasGateway"}
EspSparsnasGateway/values {"seq":44425,"watt":2949.12,"total":213.838,"pulse":"213838","battery":100,"rssi":"-88","power":"1250"}
EspSparsnasGateway/debug {"status":"Connected to Mqtt broker as EspSparsnasGateway"}
EspSparsnasGateway/values {"seq":44462,"watt":4738.303,"total":214.514,"pulse":"214514","battery":100,"rssi":"-83","power":"778"}
EspSparsnasGateway/debug {"status":"Connected to Mqtt broker as EspSparsnasGateway"}
EspSparsnasGateway/values {"seq":44488,"watt":4517.647,"total":215.11,"pulse":"215110","battery":100,"rssi":"-90","power":"816"}
EspSparsnasGateway/values {"seq":44489,"watt":4506.602,"total":215.129,"pulse":"215129","battery":100,"rssi":"-81","power":"818"}
EspSparsnasGateway/debug {"status":"Connected to Mqtt broker as EspSparsnasGateway"}
EspSparsnasGateway/debug {"status":"Connected to Mqtt broker as EspSparsnasGateway"}
EspSparsnasGateway/values {"seq":44495,"watt":4619.549,"total":215.243,"pulse":"215243","battery":100,"rssi":"-87","power":"798"}
EspSparsnasGateway/values {"seq":44496,"watt":4573.697,"total":215.263,"pulse":"215263","battery":100,"rssi":"-88","power":"806"}
EspSparsnasGateway/debug {"status":"Connected to Mqtt broker as EspSparsnasGateway"}
EspSparsnasGateway/values {"seq":44511,"watt":3963.871,"total":215.495,"pulse":"215495","battery":100,"rssi":"-89","power":"930"}
EspSparsnasGateway/debug {"status":"Connected to Mqtt broker as EspSparsnasGateway"}
EspSparsnasGateway/debug {"status":"Connected to Mqtt broker as EspSparsnasGateway"}
EspSparsnasGateway/debug {"status":"Connected to Mqtt broker as EspSparsnasGateway"}
EspSparsnasGateway/values {"seq":44573,"watt":2972.903,"total":216.365,"pulse":"216365","battery":100,"rssi":"-85","power":"1240"}
EspSparsnasGateway/values {"seq":44574,"watt":3006.852,"total":216.377,"pulse":"216377","battery":100,"rssi":"-85","power":"1226"}
EspSparsnasGateway/values {"seq":44575,"watt":3006.852,"total":216.39,"pulse":"216390","battery":100,"rssi":"-88","power":"1226"}
EspSparsnasGateway/debug {"status":"Connected to Mqtt broker as EspSparsnasGateway"}
EspSparsnasGateway/values {"seq":44578,"watt":2963.344,"total":216.427,"pulse":"216427","battery":100,"rssi":"-82","power":"1244"}
EspSparsnasGateway/debug {"status":"Connected to Mqtt broker as EspSparsnasGateway"}
EspSparsnasGateway/values {"seq":44583,"watt":3245.07,"total":216.493,"pulse":"216493","battery":100,"rssi":"-95","power":"1136"}
EspSparsnasGateway/debug {"status":"Connected to Mqtt broker as EspSparsnasGateway"}
EspSparsnasGateway/debug {"status":"Connected to Mqtt broker as EspSparsnasGateway"}
EspSparsnasGateway/values {"seq":44607,"watt":4837.795,"total":216.847,"pulse":"216847","battery":100,"rssi":"-83","power":"762"}
EspSparsnasGateway/values {"seq":44608,"watt":4775.129,"total":216.869,"pulse":"216869","battery":100,"rssi":"-84","power":"772"}
EspSparsnasGateway/debug {"status":"Connected to Mqtt broker as EspSparsnasGateway"}
EspSparsnasGateway/values {"seq":44614,"watt":3194.454,"total":216.978,"pulse":"216978","battery":100,"rssi":"-88","power":"1154"}
EspSparsnasGateway/values {"seq":44615,"watt":3188.927,"total":216.991,"pulse":"216991","battery":100,"rssi":"-91","power":"1156"}
EspSparsnasGateway/values {"seq":44616,"watt":3245.07,"total":217.005,"pulse":"217005","battery":100,"rssi":"-89","power":"1136"}
EspSparsnasGateway/debug {"status":"Connected to Mqtt broker as EspSparsnasGateway"}
EspSparsnasGateway/values {"seq":44619,"watt":4726.154,"total":217.05,"pulse":"217050","battery":100,"rssi":"-83","power":"780"}
EspSparsnasGateway/values {"seq":44620,"watt":3092.617,"total":217.066,"pulse":"217066","battery":100,"rssi":"-88","power":"1192"}
EspSparsnasGateway/debug {"status":"Connected to Mqtt broker as EspSparsnasGateway"}
EspSparsnasGateway/values {"seq":44639,"watt":3309.156,"total":217.207,"pulse":"217207","battery":100,"rssi":"-82","power":"1114"}
EspSparsnasGateway/values {"seq":44640,"watt":3256.537,"total":217.221,"pulse":"217221","battery":100,"rssi":"-94","power":"1132"}
EspSparsnasGateway/debug {"status":"Connected to Mqtt broker as EspSparsnasGateway"}
EspSparsnasGateway/debug {"status":"Connected to Mqtt broker as EspSparsnasGateway"}
EspSparsnasGateway/values {"seq":44648,"watt":3504.183,"total":217.334,"pulse":"217334","battery":100,"rssi":"-82","power":"1052"}
EspSparsnasGateway/values {"seq":44649,"watt":1647.185,"total":217.343,"pulse":"217343","battery":100,"rssi":"-89","power":"2238"}
EspSparsnasGateway/values {"seq":44650,"watt":1482.864,"total":217.349,"pulse":"217349","battery":100,"rssi":"-101","power":"2486"}
EspSparsnasGateway/debug {"status":"Connected to Mqtt broker as EspSparsnasGateway"}
EspSparsnasGateway/debug {"status":"Connected to Mqtt broker as EspSparsnasGateway"}
EspSparsnasGateway/values {"seq":44655,"watt":1647.185,"total":217.384,"pulse":"217384","battery":100,"rssi":"-88","power":"2238"}
EspSparsnasGateway/debug {"status":"Connected to Mqtt broker as EspSparsnasGateway"}
EspSparsnasGateway/values {"seq":44657,"watt":1590.337,"total":217.397,"pulse":"217397","battery":100,"rssi":"-84","power":"2318"}
EspSparsnasGateway/values {"seq":44658,"watt":1628.269,"total":217.405,"pulse":"217405","battery":100,"rssi":"-90","power":"2264"}
EspSparsnasGateway/debug {"status":"Connected to Mqtt broker as EspSparsnasGateway"}
EspSparsnasGateway/values {"seq":44660,"watt":1615.425,"total":217.419,"pulse":"217419","battery":100,"rssi":"-92","power":"2282"}
EspSparsnasGateway/values {"seq":44661,"watt":1641.318,"total":217.426,"pulse":"217426","battery":100,"rssi":"-98","power":"2246"}
EspSparsnasGateway/values {"seq":44662,"watt":1635.492,"total":217.433,"pulse":"217433","battery":100,"rssi":"-90","power":"2254"}
EspSparsnasGateway/values {"seq":44663,"watt":1598.612,"total":217.439,"pulse":"217439","battery":100,"rssi":"-94","power":"2306"}
EspSparsnasGateway/values {"seq":44664,"watt":1644.246,"total":217.446,"pulse":"217446","battery":100,"rssi":"-92","power":"2242"}
EspSparsnasGateway/debug {"status":"Connected to Mqtt broker as EspSparsnasGateway"}
EspSparsnasGateway/values {"seq":44676,"watt":3369.653,"total":217.533,"pulse":"217533","battery":100,"rssi":"-87","power":"1094"}
EspSparsnasGateway/values {"seq":44677,"watt":3382.018,"total":217.547,"pulse":"217547","battery":100,"rssi":"-93","power":"1090"}
EspSparsnasGateway/debug {"status":"Connected to Mqtt broker as EspSparsnasGateway"}
EspSparsnasGateway/values {"seq":44708,"watt":1594.464,"total":217.809,"pulse":"217809","battery":100,"rssi":"-93","power":"2312"}
EspSparsnasGateway/debug {"status":"Connected to Mqtt broker as EspSparsnasGateway"}
EspSparsnasGateway/values {"seq":44713,"watt":2944.409,"total":217.841,"pulse":"217841","battery":100,"rssi":"-84","power":"1252"}
```

Messages are sent much more frequently...

```16:54:17.781 -> Sending to mqtt: {"seq":44813,"watt":1250.475,"total":218.362,"pulse":"218362","battery":100,"rssi":"-88","power":"2948"}
16:54:18.081 -> Attempting MQTT connection...Data here????
16:54:18.114 -> Connected to Mqtt broker as EspSparsnasGateway
16:54:21.280 -> Got rf data
16:54:26.681 -> Got rf data
16:54:32.314 -> Got rf data
16:54:32.781 -> Got rf data
16:54:32.781 -> Memory usage: 36256
16:54:32.781 -> Sending to mqtt: {"seq":44814,"watt":1265.065,"total":218.368,"pulse":"218368","battery":100,"rssi":"-84","power":"2914"}
16:54:36.599 -> Got rf data
16:54:39.397 -> Got rf data
16:54:39.530 -> Attempting MQTT connection...Data here????
16:54:39.564 -> Connected to Mqtt broker as EspSparsnasGateway
16:54:42.492 -> Got rf data
16:54:47.752 -> Got rf data
16:54:47.752 -> Memory usage: 36256
16:54:47.785 -> Sending to mqtt: {"seq":44815,"watt":1249.627,"total":218.373,"pulse":"218373","battery":100,"rssi":"-81","power":"2950"}
16:54:55.417 -> Got rf data
16:54:57.651 -> Got rf data
16:55:01.526 -> Attempting MQTT connection...Data here????
16:55:01.560 -> Connected to Mqtt broker as EspSparsnasGateway
16:55:02.767 -> Got rf data
16:55:02.767 -> Memory usage: 37600
16:55:02.767 -> Sending to mqtt: {"seq":44816,"watt":1237.878,"total":218.379,"pulse":"218379","battery":100,"rssi":"-85","power":"2978"}
```

dogmatic69, 2019-01-20:
I have debugged the pubsub package and the code is run all the way to at least the below line, and the result is true as I added some code to debug that.

```rc = _client->write(buf+(MQTT_MAX_HEADER_SIZE-hlen),length+hlen);```

dogmatic69, 2019-01-21:
After more debugging last night it started "working" and every single message was sent to MQTT.

Tonight I recompiled the same code and nothing is getting sent again. There is something really strange going on.

dogmatic69, 2019-02-18:
Seems to be stable now. Not seen any issues after weeks and many restarts

Closed 2019-02-18.

Thread 31 (2019-01-21):

Add software RST since it's missing

Naesstrom, 2019-01-21:
So reading up on the [manual for the BOB](https://cdn-learn.adafruit.com/downloads/pdf/adafruit-rfm69hcw-and-rfm96-rfm95-rfm98-lora-packet-padio-breakouts.pdf) I found a couple of pieces that might be interesting here.

1. Define a rst pin
```
#if defined (__AVR_ATmega328P__) // UNO or Feather 328P w/wing
#define RFM69_INT 3 //
#define RFM69_CS 4 //
#define RFM69_RST 2 // "A"
#define LED 13
#endif
```
### Setup
We begin by setting up the serial console and hard-resetting the RFM69
```
void setup()
{
Serial.begin(115200);
//while (!Serial) { delay(1); } // wait until serial console is open, remove if not tethered to computer
pinMode(LED, OUTPUT);
pinMode(RFM69_RST, OUTPUT);
digitalWrite(RFM69_RST, LOW);
Serial.println("Feather RFM69 RX Test!");
Serial.println();
// manual reset
digitalWrite(RFM69_RST, HIGH);
delay(10);
digitalWrite(RFM69_RST, LOW);
delay(10);
```

2. Setting the transmit power needed for the **HCW** board
### Initializing Radio
For transmission power you can select from 14 to 20 dBi. Lower numbers use less power, but have less range. **The second argument to the function is whether it is an HCW type radio, with extra amplifier. This should always be set to true!**
```
if (!rf69.init()) {
Serial.println("RFM69 radio init failed");
while (1);
}
Serial.println("RFM69 radio init OK!");
// Defaults after init are 434.0MHz, modulation GFSK_Rb250Fd250, +13dbM (for low power module)
// No encryption
if (!rf69.setFrequency(RF69_FREQ)) {
Serial.println("setFrequency failed");
}
// If you are using a high power RF69 eg RFM69HW, you *must* set a Tx power with the
// ishighpowermodule flag set like this:
rf69.setTxPower(20, true); // range from 14-20 for power, 2nd arg must be true for 69HCW
// The encryption key has to be the same as the one in the server
uint8_t key[] = { 0x01, 0x02, 0x03, 0x04, 0x05, 0x06, 0x07, 0x08,
0x01, 0x02, 0x03, 0x04, 0x05, 0x06, 0x07, 0x08};
rf69.setEncryptionKey(key);
```

And after that it's just the normal transmit code but I think we could use some of these changes for this one since it's the RFM69**HCW** that's listed in the materials section!

dogmatic69, 2019-01-21:
Does TX power have any relevance in this project? We are receiving data only, no need to transmit.

Naesstrom, 2019-01-21:
> Does TX power have any relevance in this project? We are receiving data only, no need to transmit.

Ah true, so then it's only the setup we need to add and assign rst to a free pin!

kalj, 2019-01-22:
Great! This is probably the more correct way of doing this, rather than the crude RST-to-GND hack.

kalj, 2019-01-22:
We need to make sure to not be too specific to the Adafruit BoB. I think many people are using the plain RFM69HCW module and it would be great to have everything somewhat general. As far as I understand, the whole RST issue was only experienced using the Adafruit BoB. Can we generalize the code and/or the wiring?

kalj, 2019-01-22:
Yeah, two different wirings or an explanation of the main differences is
probably enough.

I can look into setting up something robust for the code.

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

dogmatic69, 2019-01-22:
I've done some quick tests and I am not convinced on the ground -> rst issue.

Without it connected radio does not start.

```
21:53:12.445 -> Sensor id sub: 2731498642
21:53:12.445 -> In initialize, frequency = 867990000
21:53:12.445 -> Adjusted freq: 14221148
21:53:12.445 -> 61.04
21:53:12.478 -> ERROR: Failed setting syncvalue1 1st time
21:53:12.511 -> Unable to initialize the radio. Exiting.
```

So with the ground connected and started I disconnect ground and then it stops transmitting data.

```
21:51:43.760 -> Sending to mqtt: {"seq":57524,"watt":1009.419,"total":279.793,"pulse":"279793","battery":100,"rssi":"-81","power":"3652"}
21:51:43.760 -> wifi connected: True
21:51:43.760 -> shits good, lets go!
21:51:43.760 -> Data here????
21:51:44.297 -> client.loop
21:51:45.298 -> client.loop
21:51:46.298 -> client.loop
21:51:47.296 -> client.loop
21:51:47.362 -> Got rf data
21:51:48.296 -> client.loop
21:51:48.296 -> client is availale
21:51:48.296 -> len: 2
21:51:48.296 -> Time to MQTTPINGRESP
21:51:49.294 -> client.loop
21:51:50.294 -> client.loop
21:51:51.297 -> client.loop
21:51:52.300 -> client.loop
21:51:53.295 -> client.loop
21:51:54.294 -> client.loop
21:51:55.295 -> client.loop
21:51:56.294 -> client.loop
21:51:57.294 -> client.loop
21:51:58.295 -> client.loop
21:51:58.761 -> Got rf data
21:51:58.761 -> Memory usage: 43376
21:51:58.761 -> Sending to mqtt: {"seq":57525,"watt":1001.195,"total":279.797,"pulse":"279797","battery":100,"rssi":"-87","power":"3682"}
21:51:58.761 -> wifi connected: True
21:51:58.761 -> shits good, lets go!
21:51:58.761 -> Data here????
21:51:58.861 -> Got rf data
21:51:59.294 -> client.loop
21:52:00.273 -> client.loop
21:52:01.270 -> client.loop
21:52:02.267 -> client.loop
21:52:03.297 -> client.loop
21:52:04.298 -> client.loop
21:52:05.295 -> client.loop
21:52:06.267 -> client.loop
21:52:06.401 -> Got rf data
21:52:07.298 -> client.loop
21:52:08.296 -> client.loop
21:52:09.295 -> client.loop
21:52:10.294 -> client.loop
21:52:10.294 -> client is availale
21:52:10.294 -> len: 2
21:52:10.294 -> Time to MQTTPINGRESP
21:52:11.294 -> client.loop
21:52:12.294 -> client.loop
21:52:13.294 -> client.loop
21:52:13.761 -> Got rf data
21:52:13.761 -> Memory usage: 43376
21:52:13.761 -> Sending to mqtt: {"seq":57526,"watt":1006.663,"total":279.801,"pulse":"279801","battery":100,"rssi":"-76","power":"3662"}
21:52:13.761 -> wifi connected: True
21:52:13.761 -> shits good, lets go!
21:52:13.761 -> Data here????
21:52:14.294 -> client.loop
21:52:14.827 -> Got rf data
21:52:15.295 -> client.loop
21:52:16.294 -> client.loop
21:52:17.298 -> client.loop
21:52:18.297 -> client.loop
21:52:18.829 -> Got rf data
21:52:19.295 -> client.loop
21:52:20.294 -> client.loop
21:52:21.294 -> client.loop
21:52:22.294 -> client.loop
21:52:23.296 -> client.loop
21:52:24.294 -> client.loop
21:52:25.294 -> client.loop
21:52:25.560 -> Got rf data
21:52:26.293 -> client.loop
21:52:27.296 -> client.loop
21:52:28.167 -> Got rf data
21:52:28.300 -> client.loop
21:52:28.766 -> Got rf data
21:52:28.766 -> Memory usage: 43376
21:52:28.766 -> Sending to mqtt: {"seq":57527,"watt":1005.565,"total":279.805,"pulse":"279805","battery":100,"rssi":"-81","power":"3666"}
21:52:28.766 -> wifi connected: True
21:52:28.766 -> shits good, lets go!

// disconnected ground around here. Before here you can see a message every ~ 15 seconds.

21:52:28.766 -> Data here????
21:52:29.297 -> client.loop
21:52:30.297 -> client.loop
21:52:30.766 -> Got rf data
21:52:31.299 -> client.loop
21:52:32.295 -> client.loop
21:52:32.295 -> client is availale
21:52:32.295 -> len: 2
21:52:32.295 -> Time to MQTTPINGRESP
21:52:33.295 -> client.loop
21:52:34.295 -> client.loop
21:52:35.295 -> client.loop
21:52:36.298 -> client.loop
21:52:36.365 -> Got rf data
21:52:37.295 -> client.loop
21:52:38.295 -> client.loop
21:52:39.292 -> client.loop
21:52:40.289 -> client.loop
21:52:41.286 -> client.loop
21:52:42.288 -> client.loop
21:52:43.284 -> client.loop
21:52:44.281 -> client.loop
21:52:45.284 -> client.loop
21:52:46.284 -> client.loop
21:52:47.283 -> client.loop
21:52:48.286 -> client.loop
21:52:49.282 -> client.loop
21:52:50.284 -> client.loop
21:52:51.282 -> client.loop
21:52:52.279 -> client.loop
21:52:52.279 -> client is availale
21:52:52.279 -> len: 2
21:52:52.279 -> Time to MQTTPINGRESP
21:52:53.279 -> client.loop
21:52:54.278 -> client.loop
21:52:55.280 -> client.loop
21:52:56.279 -> client.loop
21:52:57.276 -> client.loop
21:52:58.272 -> client.loop
21:52:59.301 -> client.loop
21:53:00.300 -> client.loop
21:53:01.296 -> client.loop
21:53:02.293 -> client.loop
21:53:03.290 -> client.loop
21:53:04.288 -> client.loop
21:53:05.291 -> client.loop
21:53:06.287 -> client.loop
21:53:07.286 -> client.loop
21:53:08.288 -> client.loop
21:53:09.285 -> client.loop
21:53:10.283 -> client.loop
21:53:10.781 -> ;l d⸮⸮| ⸮$⸮|
 ⸮
d⸮ c|ǃ ⸮ ⸮{⸮c⸮
b⸮⸮og⸮l'o⸮⸮⸮
#
x⸮⸮l{            // ======= RESET pushed. its nearly 45 seconds without a message.
```

bphermansson, 2019-11-27:
Open this again if it's still relevant.

Closed 2019-11-27.

Thread 37 (2019-01-24):

Use the RFM69 libs directly

dogmatic69, 2019-01-24:
Currently there is a "copy" of that lib in here meaning we need to maintain it. We should replace all the RMF69 code with what is provided with the [lib](https://github.com/LowPowerLab/RFM69).

That will also make this work on more boards out the box.

bphermansson, 2019-10-02:
I tried to get this working but failed. Seems you have to adjust settings in the lib itself for it to work in this application, and then the meaning with using the lib is almost gone.
There shall be a possibility to change the library files at compile time with PlatformIO, but I don't think i'ts worth it.

Closed 2019-10-02.

Thread 41 (2019-09-14):

Socket error

riksarchen, 2019-09-14:
MQTT connects and then disconnects within a second.

>1568413360: New client connected from 192.168.1.251 as EspSparsnasGatewayV2 (p2, c1, k30, u'hidden').
1568413360: Socket error on client EspSparsnasGatewayV2, disconnecting.
>
Worked fine with old version.

Hardware i use is a nodemcu esp8266, same as the one described in the guide.

bphermansson, 2019-09-14:
Tried to checkout and use the v1_original branch?
Do you use Mosquitto as broker software? If you do, try running it from the command line with the -d parameter.

riksarchen, 2019-09-15:
Tried v1. It does not seems to even try MQTT connection. I also tried -d and -v to see log.

V1 does not connect at all, v2 connect and CONNACK is sent but then it's disconnected with Socket error.

I'll try to swap the Amico ESP8266 to a wemos d1 mini.

riksarchen, 2019-09-28:
Tried with wemos D1 mini also now but still gets socket error as soon as it connects.

bphermansson, 2019-10-02:
Got this too now, with a circuit that's been working good before. Calls for further investigation.

```
sudo cat /var/log/mosquitto/mosquitto.log
1570009721: New connection from 192.168.1.235 on port 1883.
1570009721: New client connected from 192.168.1.235 as mosqsub|18035-PatrikAth (c1, k60, u'emonpi').
1570009785: Socket error on client mosqsub|18035-PatrikAth, disconnecting.
```

bphermansson, 2019-11-27:
@riksarchen, you don't have this problem with your pubsub-version?

Thread 48 (2019-11-24):

Drastically wrong power reported when there is few pulses

nbasse, 2019-11-24:
Wrong power is being reported when there is a low load in the system making it take longer time between the light pulses on the meter.
For example, when there is 250-350W being consumed, the EspSparsnasGateway reports 10-20W, (with 100 pulses/Kwh for the meter, therefore approximately 3 minutes between the pulses).
But higher loads, for example, 2000w gets reported correctly.

Attached serial log shows first an apartment at approx 300w, then a kettle is turned on raising the power to above 2000w and then it is turned off again.
(Most of the bad packets received have been filtered away to make the log shorter.)

[debug_log.txt](https://github.com/bphermansson/EspSparsnasGateway/files/3883963/debug_log.txt)

nbasse, 2019-11-24:
After performing more experiments, I have found the breaking-point to be somewhere between 599W (still working) and 557W (not working)

(All "real" values are from the original Sparsnäs display)

riksarchen, 2019-11-24:
I think the problem is not the decoded power but the number of pulses within a timespan.

Your setup was 100 pulses per kWh, Confirm?

nbasse, 2019-11-24:
Yes, that is correct. 100 pulses /KWh

bphermansson, 2019-11-27:
I've added a function to print raw power values to the serial port. Not tested.

nbasse, 2019-11-28:
> I've added a function to print raw power values to the serial port. Not tested.

Not sure how I can test this. I am currently using @riksarchen fork as it has some tweaks to make it work with the board he deigned.

Some sort of raw values are already being printed, (see the log in my first post) are these different from the ones you added?

fredrike, 2020-03-26:
Could this be the same issue: https://github.com/tubalainen/sparsnas_decoder/pull/12/files

fredrike, 2020-03-28:
@nbasse, we need to see your `data4` value for the low power mode, but I suspect that we might have a case of `data4 = 3` which is not covered in the code..

https://github.com/bphermansson/EspSparsnasGateway/blob/38d3c45e60781a739a027dc910163e9dcb6d83e7/src/RFM69functions.cpp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

nbasse, 2020-03-30:
@fredrike
Data4 seems to be 1 at higher loads when everything is working and 0 when at lower loads when wrong power is being reported.

`Seq 18017: 1585594856, 624.72 W, total: 1190 kWh, battery 100%, rssi -108dBm. Power(raw): 59009 Vcc: 2993.00mV, Data4: 1`

`Seq 17972: 1585594181, 17.95 W, total: 1190 kWh, battery 100%, rssi -123dBm. Power(raw): 7478 Vcc: 2993.00mV, Data4: 0`

fredrike, 2020-03-31:
> Data4 seems to be 1 at higher loads when everything is working and 0 when at lower loads when wrong power is being reported.

Great! What is the consumtion with `Data4 = 0` and `Power(raw) = 7478` ? I.e., what formula should we use for that case?

nbasse, 2020-03-31:
Yes, started doing this yesterday, but only had the time to get 5 or 6 value pairs. And since the original display only shows whole watts, I think some more values would be good to get a better formula.

I started by fitting a straight line to the values. but I'm not sure where I should add the parameter for pluses/KWh. I will look into this more later today or tomorrow and try to get some more readings.

fredrike, 2020-03-31:
> I started by fitting a straight line to the values. but I'm not sure where I should add the parameter for pluses/KWh. I will look into this more later today or tomorrow and try to get some more readings.

Just post the readings here and I can try to find the factor for you.

nbasse, 2020-04-01:
OK, Here are some readings!
watt =[ 508 466 456 460 465 465 468 200 171 150 141 133 120 114 184 268 263 291 353]
raw = [4530 4934 5042 5003 4946 4948 4913 11501 13421 15341 16301 17261 19181 20055 12471 8575 8730 7895 6512]

Apparently it is not a linear relationship between the value pairs as I expected.
See attached plot
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

nbasse, 2020-08-01:
I have now fitted a exponential model to the values I recorded and extracted some coefficients.
I have successfully added it to the code and get good values even when data4 = 0. See https://github.com/nbasse/EspSparsnasGateway/commit/9f872e2a968904546745ac9a8cc33a35112ee8b3

I'm not sure if I correctly accounted for the number of pulses. So someone with a value other than 100 should try this to see if it is correct.
(Or maybe someone can just double-check the math? I just multiplied the value I got for C_a with 100 and then divided the calculated power with the number of pulses. Not sure if this is correct for all cases.)

fredrike, 2020-08-02:
Great job!

I suggest that you send this as a pull-request so @bphermansson can merge it.

Thread 50 (2019-12-15):

Enable second transmitter id

SweNilsson, 2019-12-15:
By monitoring more than one energy meter at home it would be possible to keep consumption from the Car and the Heating system on separate "tabs". I imagine that the code change would be rather small, but I can't achieve this myself with my lacking programming skills. My current need is to receive data from two transmitters.

My idea to solve the need:
Setup transmitter_id2 in settings.h
either add watt2, total2 and battery2 to the MQTT message or create a separate message in case two transmitter ids have been set.

Sperra, 2020-02-13:
You can try this one: https://github.com/Sperra/EspSparsnasGateway

SweNilsson, 2020-02-14:
Thanks @Sperra ! What is the json value ids? I've tried to check the code but I'm not qualified to read it. Today I have a sensor reading this "value_json.watt" but now I need two different I guess?

Sperra, 2020-02-14:
During startup and initializing it uses the following for information and debug.
EspSparsnasGateway/values
EspSparsnasGateway/debug

Meassurment are sent with the following
EspSparsnasGateway/Sensor1/values
EspSparsnasGateway/Sensor1/debug
EspSparsnasGateway/Sensor2/values
EspSparsnasGateway/Sensor2/debug

Values are the same as before: seq, timestamp, watt, total, battery and rssi

I have the following setup for wat in my OpenHAB
Number sensors_sparsnas_watt "watt [%.1f W]" (gpower) {mqtt="<[mosquitto:EspSparsnasGateway/Sensor1/values:state:JSONPATH($.watt)]"}

SweNilsson, 2020-02-14:
Great! Exactly what I was looking for

bphermansson, 2020-02-14:
Great work! Just wished it'd been a PR here instead of a fork.

Sperra, 2020-02-15:
Sprry my faiult! Totaly new to GitHub. I will try to do a PR  during het weekend.

dogmatic69, 2020-02-15:
It's easy to make a [PR from a fork](https://github.com/bphermansson/EspSparsnasGateway/compare/master...Sperra:master)

Closed 2020-02-14.

Thread 54 (2020-04-01):

Support for MQTT-Discovery in HA

fredrike, 2020-04-01:
This is not really an issue as I already have a working draft. More a heads-up that https://github.com/fredrike/EspSparsnasGateway/commit/ce54c56d7d22fca426e0615b3bc3ebdf0c01dba9 https://github.com/fredrike/EspSparsnasGateway/tree/auto_discovery adds support for https://www.home-assistant.io/docs/mqtt/discovery/.

I'm currently testing and cleaning the code a bit but will send a PR when I think it is ready.

fredrike, 2020-06-12:
My changes can't be merged until the https://github.com/bphermansson/EspSparsnasGateway/pull/52 is reverted.

Closed 2020-06-14.

Thread 55 (2020-04-02):

Suggestion: create a Sparsnas class that handles everything related to the received package

fredrike, 2020-04-02:
It's been bugging me the whole day yesterday and I think the sparsnäs decoding should be extracted to a separate class. This will enable easy access to multiple sensors like @Sperra suggested and also much cleaner code base.

My suggestion is that we move most parts of `interruptHandler()` into a class like this one:

```c++
class Sparsnas
{
private:
    uint32_t my_sensor_id;
    uint16_t my_pulses_per_kwh;
    uint8_t my_received_data[21];
    uint8_t my_decrypted_data[21];

 static:
    bool check_crc(unit8_t data[18]);

public:
    Sparsnas(uint32_t sensor_id, uint16_t pulses_per_kwh, uint8_t received_data[21);
    bool isValidPackage();  // This will do the decryption and crc_check.
    uint16_t getPower();
    float getWatt();
    uint16_t getSequence();
    char* getStatusString();
    char* getJsonString();
};
```

This means that https://github.com/fredrike/EspSparsnasGateway/blob/ce54c56d7d22fca426e0615b3bc3ebdf0c01dba9/src/RFM69functions.cpp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 can be replaced with (and that the Sparsnas class can be reused in other projects):

```c++
    // Read 20 bytes
    for (uint8_t i = 0; i < 20; i++) {
      TEMPDATA[i] = SPI.transfer(0);
    }
    Sparsnas* sp = new Sparsnas(SENSOR_ID, PULSES_PER_KWH, TEMPDATA);

    if(sp->isValisPackage()) {
        mClient.publish(mqtt_status_topic, sp->getJsonString());
    } else {
        mClient.publish(mqtt_debug_topic, sp->getJsonString());
    }
```

We might need to add some fancy handling of LEDs and such (in my example above, the class should be native c++) but this is a base :).

fredrike, 2020-04-02:
We could use the code from https://github.com/merbanan/rtl_433/blame/master/src/devices/ikea_sparsnas.c (it is quite clean). Perhaps @merbanan can help with that (would be really nice to "borrow" his sensor bruteforce part.

merbanan, 2020-04-02:
@slundell is the original author. But you are free to use the code under the gplv2 license, if you need another license you have to ask the original author.

bphermansson, 2020-07-16:
Looks like a good idea. Why don't make a test branch that uses @merbanans code?

fredrike, 2020-07-18:
> Looks like a good idea. Why don't make a test branch that uses @merbanans code?

I'll take a look at this after vacation time (perhaps even in November 😄). I need to solder a dev unit as I've actually moved to production now.

Thread 64 (2022-12-15):

Example code will not work out-of-the-box with energy dashboard in HA

lellky, 2022-12-15:
In the example code we have the following

```
  - state_topic: "EspSparsnasGateway/valuesV2"
    name: "House energy usage"
    unit_of_measurement: "kWh"
    value_template: "{{ float(value_json.total) | round(0)  }}"
    icon: mdi:flash-circle
    state_class: measurement
    device_class: energy
```

But when this sensor is added as the "Grid consumption" sensor, home assistant complains about "The following entities have state class 'measurement' but 'last_reset' is missing".

Changing `state_class` to total seems to (maybe) fix the problem.
