bphermansson/EspSparsnasGateway/(commit log)

2018-01-14 Changed 'effect' to 'power'
2018-01-18 New schematic
2018-01-21 Added capacitors for stability
2018-02-03 Changed types for power and total to float for better compability
2018-02-18 Added ability to control device via Mqtt
2018-02-25 Added pulse to Mqtt message. Changed datatype from int to uint for power value to fix issue #9
2018-03-02 fix for power calculation when data4 is 0
    Apparently is data4 set to 0 when the power usage is low (around <400W in 10'000 pulses per kwh) and then is watt calculated as `power * 0.24 / PULSES_PER_KWH`.
    fixes bphermansson/EspSparsnasGateway#9
2019-01-13 use float division to get fractional power
2019-01-20 Fix total rounding
    Currently if you have `1000` pulse per `kw` and you have `100050` pulses you will get a total value of `1000.00`. This will now read `1000.50`.
2019-01-21 Update requirements and include the wiring diagram in the readme
2019-07-30 Current timestamp added to output.
2019-09-24 Initial support for three status leds.
2019-09-24 With blinking leds
2019-11-27 Added debug function which prints raw power data to the serial console.
2019-11-28 Outputs hex value for power
2020-07-18 Moved schematics
2021-08-18 Better error messages when connections fail.
    [EspSparsnasGateway.cpp, RFM69functions.cpp, reconn.cpp]
